kattlelattle/stm32-swing-analyzer/results/2026-11-11_scope_freq_1kHz.png

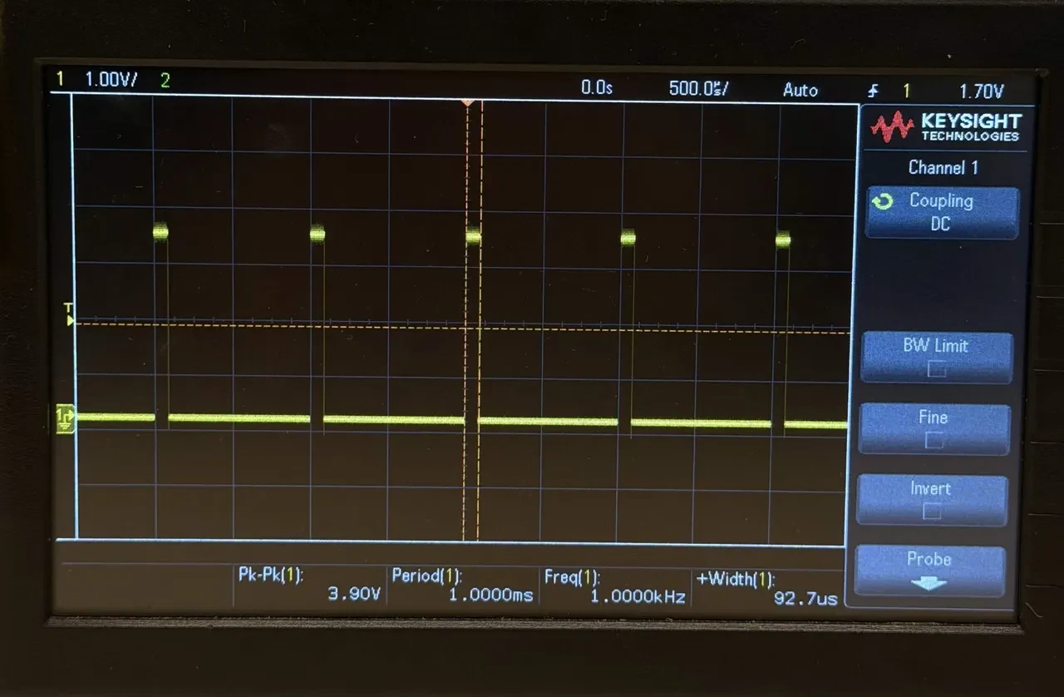
results/2026-11-11_scope_freq_1kHz.png
