kattlelattle/stm32-swing-analyzer/results/2026-11-11_scope_jitter_23ns.png

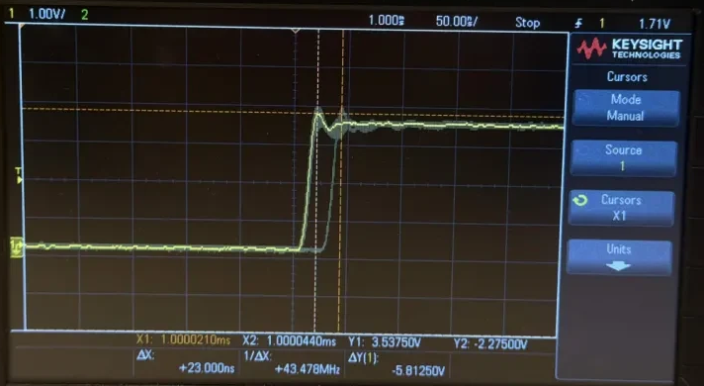
results/2026-11-11_scope_jitter_23ns.png
