kattlelattle/stm32-swing-analyzer/firmware/cubeide/Core/Inc/main.h

#define USART_TX_Pin GPIO_PIN_2
#define USART_TX_GPIO_Port GPIOA
#define USART_RX_Pin GPIO_PIN_3
#define USART_RX_GPIO_Port GPIOA
#define DBG_Pin GPIO_PIN_8
#define DBG_GPIO_Port GPIOA
#define TMS_Pin GPIO_PIN_13
#define TMS_GPIO_Port GPIOA
#define TCK_Pin GPIO_PIN_14
#define TCK_GPIO_Port GPIOA
#define SWO_Pin GPIO_PIN_3
#define SWO_GPIO_Port GPIOB
#define IMU_CS_Pin GPIO_PIN_6
#define IMU_CS_GPIO_Port GPIOB
