kattlelattle/stm32-swing-analyzer/(commit log)

2026-11-11 Add BMI270 SPI driver
2026-11-11 Add sampling and UART firmware
2026-11-11 Add STM32CubeIDE project
